Artree021/OpenTendonHand/pcb/README.md

# 电路板 / PCB

| 文件 | 说明 |
| --- | --- |
| `AD7606b-gerber.zip` | Gerber 打板文件（GTL/GBL/丝印/阻焊/板框等 19 个文件） |

完整的原理图、PCB、BOM 见**立创开源广场（OSHWHub）**，可在那里直接下单：

## https://oshwhub.com/shusheng60602/ad7606b

---

| File | Contents |
| --- | --- |
| `AD7606b-gerber.zip` | Gerber fabrication files |

Schematic, PCB and BOM are published on OSHWHub:

<https://oshwhub.com/shusheng60602/ad7606b>
