Artree021/OpenTendonHand/solidworks/磁编码器.SLDASM

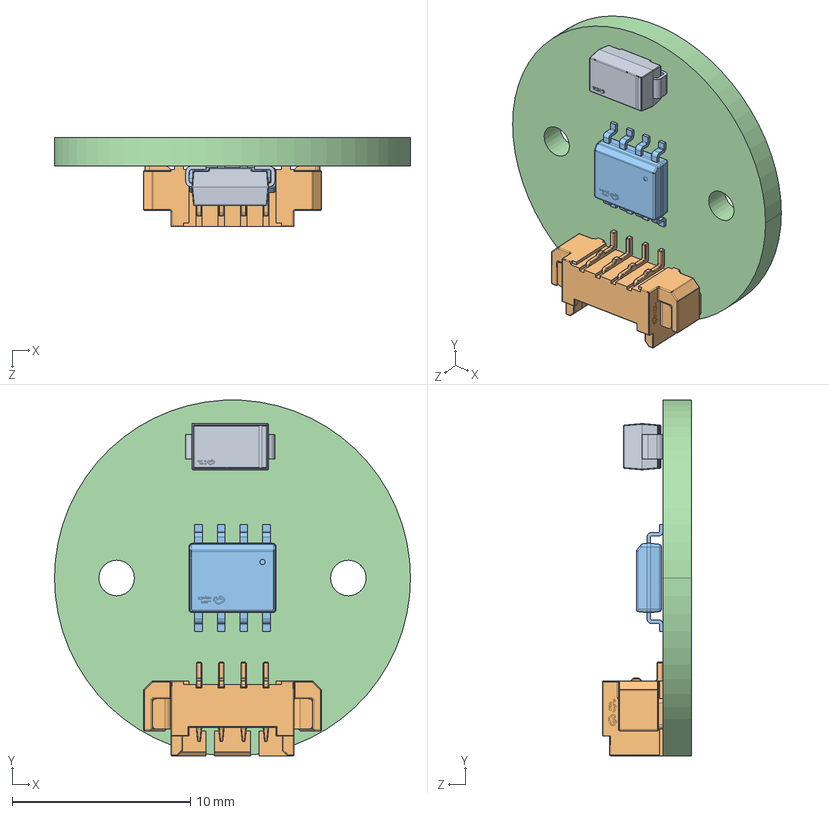
[picture p23: CAD file, 2026-11-03]
solidworks/磁编码器.SLDASM
20.0 x 19.9 x 5.00 mm
SOLID^SMA_L4.3-W2.6-LS5.0-RD_D18_磁编码器
COMPOUND^CONN-SMD_4P-P1.25-HC-1.25-4PWT_CN1_磁编码器
COMPOUND-1^SOP-8_L4.9-W3.9-P1.27-LS6.0-BL_U3_磁编码器
COMPOUND-3^磁编码器
