Artree021/OpenTendonHand/solidworks/驱动底座2.SLDASM

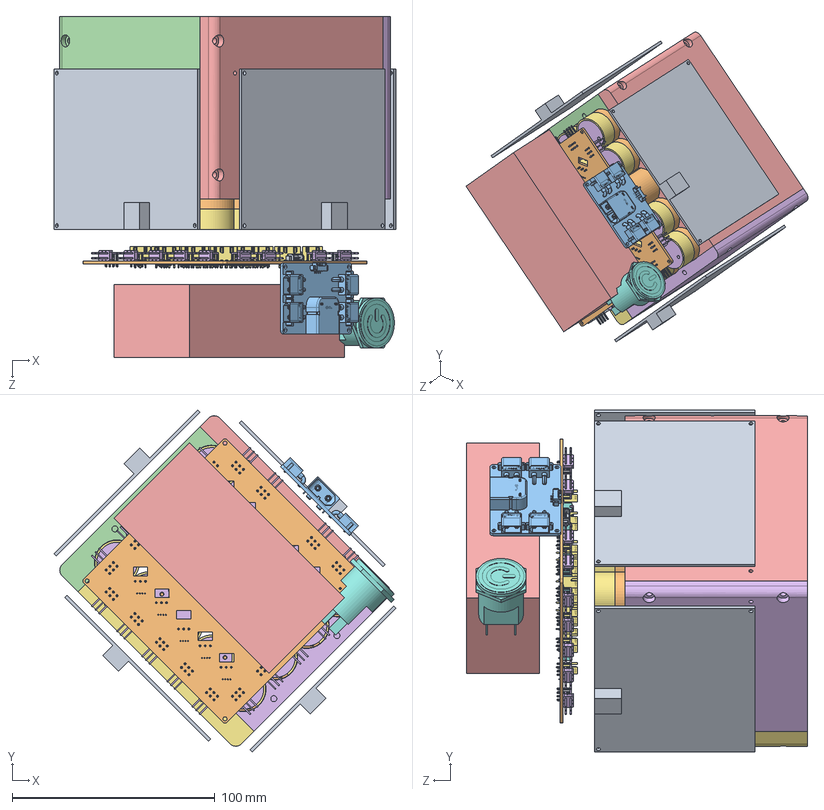
[picture p24: CAD file, 2026-11-03]
solidworks/驱动底座2.SLDASM
168.4 x 168.4 x 168.0 mm
空心杯电机 x 19
SOLID^SMA_L4.3-W2.6-LS5.0-RD_D18_磁编码器 x 19
COMPOUND^CONN-SMD_4P-P1.25-HC-1.25-4PWT_CN1_磁编码器 x 19
COMPOUND-1^SOP-8_L4.9-W3.9-P1.27-LS6.0-BL_U3_磁编码器 x 19
COMPOUND-3^磁编码器 x 19
配件1 x 19
电机轴套_双通 x 8
电机盖_双通 x 8
电机轴套_双通_test x 8
电机盖_单通_0714 x 11
电机轴套_单通_test x 11
6s电池
机械手控制电路板 x 4
HDR-TH_6P-P2.54-H-M-R2-C3-S2.54~HDR-TH_6P-P2.54-M-WI-2X3P~Z7h2^复件 H1~HDR-TH_6P-P2.54-H-M-R2-C3-S2.54~HDR-TH_6P-P2.54-M-WI-2X3P~Z7h2_电机底板 x 19
CONN-TH_3P-P2.54_2501S-3P~CONN-TH_3P-P2.54_2501S-3P~Z7h2^复件 CN1~CONN-TH_3P-P2.54_2501S-3P~CONN-TH_3P-P2.54_2501S-3P~Z7h2_电机底板 x 19
CONN-TH_DF13-4P-1.25DSA~CONN-TH_DF13-4P-1.25DSA~Z7h2^复件 CN2~CONN-TH_DF13-4P-1.25DSA~CONN-TH_DF13-4P-1.25DSA~Z7h2_电机底板 x 19
CONN-SMD_4P-P1.25-HC-1.25-4PWT~CONN-SMD_4P-P1.25-HC-1.25-4PWT~Z7h2^复件 CN39~CONN-SMD_4P-P1.25-HC-1.25-4PWT~CONN-SMD_4P-P1.25-HC-1.25-4PWT~Z7h2_电机底板
复件 Board~Z7h2
总电源板
底座侧罩1
底座侧罩2
底座侧罩3
底座侧罩4
电源按键
