Artree021/OpenTendonHand/solidworks/双通关节模组.SLDASM

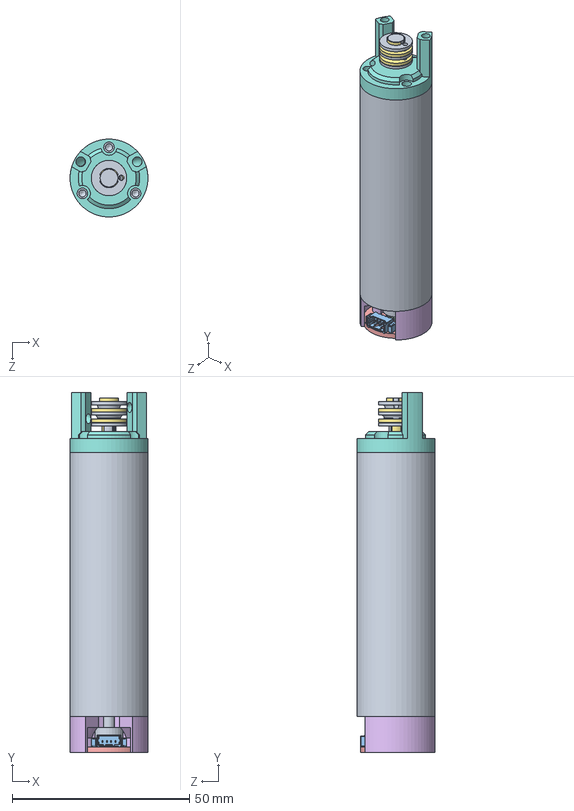
[picture p25: CAD file, 2026-11-03]
solidworks/双通关节模组.SLDASM
22.0 x 101.6 x 22.0 mm
空心杯电机
SOLID^SMA_L4.3-W2.6-LS5.0-RD_D18_磁编码器
COMPOUND^CONN-SMD_4P-P1.25-HC-1.25-4PWT_CN1_磁编码器
COMPOUND-1^SOP-8_L4.9-W3.9-P1.27-LS6.0-BL_U3_磁编码器
COMPOUND-3^磁编码器
配件1
电机盖_双通
电机轴套_双通_test
