Artree021/OpenTendonHand/solidworks/二代全手搭建_圆盘型_all.SLDASM

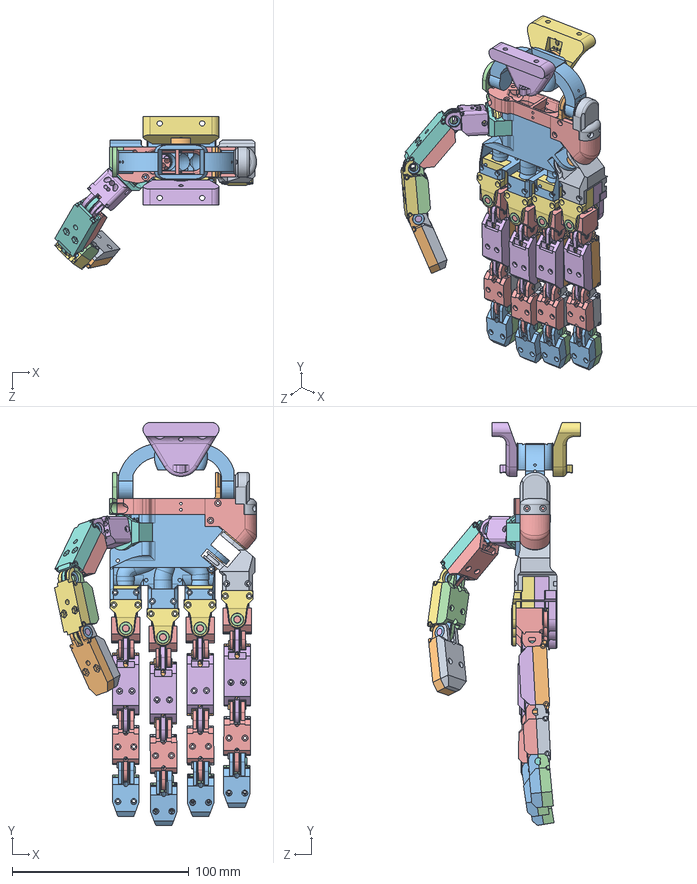
[picture p27: CAD file, 2026-11-03]
solidworks/二代全手搭建_圆盘型_all.SLDASM
114.2 x 227.7 x 86.6 mm
小法兰轴承_代2圆盘型_all x 16
前远指节_代2圆盘型_all x 4
前近指节_代2圆盘型_all x 4
前底座_代2圆盘型_all x 4
关节轴_代2圆盘型_all x 4
后远指节_代2圆盘型_all x 4
后近指节_代2圆盘型_all x 4
前指拇_代2圆盘型_all x 4
后指拇_代2圆盘型_all x 4
左根部座_2版_代2圆盘型_all x 4
后底座_代2圆盘型_all x 4
P_关节电位器_代2圆盘型_all x 19
P2_关节电位器_代2圆盘型_all x 19
手掌固定架_代2圆盘型_all
小拇指固定架1_代2圆盘型_all
8_14_4法兰轴承_代2圆盘型_all x 3
小指拇固定架2_代2圆盘型_all
小法兰轴承_圆盘型_all x 2
前远指节_圆盘型_all
前近指节_圆盘型_all
关节轴_圆盘型_all
后远指节_圆盘型_all
后近指节_圆盘型_all
前指拇_圆盘型_all
后指拇_圆盘型_all
P_关节电位器_圆盘型_all x 4
P2_关节电位器_圆盘型_all x 4
8_14_4法兰轴承_all x 2
左根部座_圆盘型2_all
大拇指根部件1_all
大拇指根部件2_all
8_12_3.5法兰轴承_all x 3
手掌固定架3_代2圆盘型_all
手掌固定架4_代2圆盘型_all
腕部支撑架1
手掌固定架5_代2圆盘型_all
手掌固定架2_代2圆盘型_all
腕部支撑架2
腕部支撑架3
