Artree021/OpenTendonHand/solidworks/关节电位器_代2圆盘型_all.SLDASM

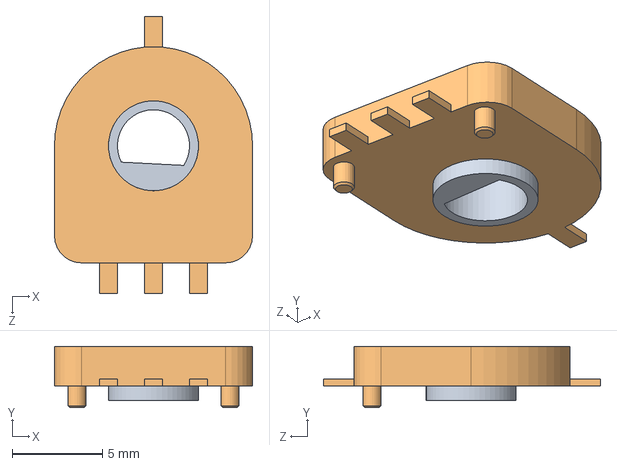
[picture p28: CAD file, 2026-11-03]
solidworks/关节电位器_代2圆盘型_all.SLDASM
11.0 x 3.40 x 15.4 mm
P_关节电位器_代2圆盘型_all
P2_关节电位器_代2圆盘型_all
