Artree021/OpenTendonHand/step/机械手整体.STEP

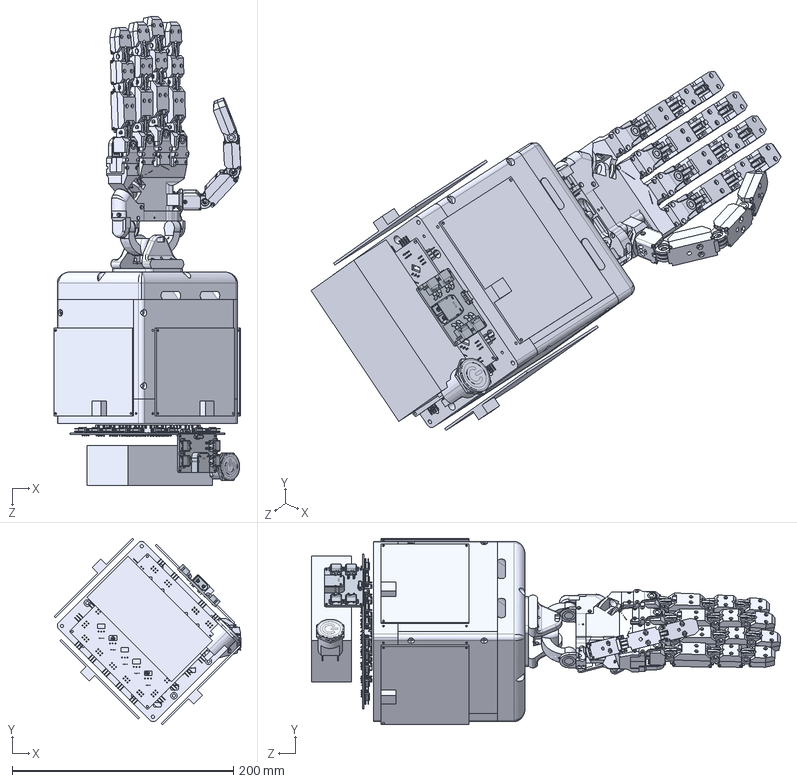
[picture p29: CAD file, 2026-11-03]
step/机械手整体.STEP
168.7 x 168.4 x 423.7 mm
小法兰轴承_代2圆盘型_all x 16
前远指节_代2圆盘型_all x 4
前近指节_代2圆盘型_all x 4
前底座_代2圆盘型_all x 4
关节轴_代2圆盘型_all x 4
后远指节_代2圆盘型_all x 4
后近指节_代2圆盘型_all x 4
前指拇_代2圆盘型_all x 4
后指拇_代2圆盘型_all x 4
左根部座_2版_代2圆盘型_all x 4
后底座_代2圆盘型_all x 4
P_关节电位器_代2圆盘型_all x 19
P2_关节电位器_代2圆盘型_all x 19
手掌固定架_代2圆盘型_all
小拇指固定架1_代2圆盘型_all
8_14_4法兰轴承_代2圆盘型_all x 3
小指拇固定架2_代2圆盘型_all
小法兰轴承_圆盘型_all x 2
前远指节_圆盘型_all
前近指节_圆盘型_all
关节轴_圆盘型_all
后远指节_圆盘型_all
后近指节_圆盘型_all
前指拇_圆盘型_all
后指拇_圆盘型_all
P_关节电位器_圆盘型_all x 4
P2_关节电位器_圆盘型_all x 4
8_14_4法兰轴承_all x 2
左根部座_圆盘型2_all
大拇指根部件1_all
大拇指根部件2_all
8_12_3.5法兰轴承_all x 3
手掌固定架3_代2圆盘型_all
手掌固定架4_代2圆盘型_all
腕部支撑架1
手掌固定架5_代2圆盘型_all
手掌固定架2_代2圆盘型_all
腕部支撑架2
腕部支撑架3
空心杯电机 x 19
SOLID^SMA_L4.3-W2.6-LS5.0-RD_D18_磁编码器 x 19
COMPOUND^CONN-SMD_4P-P1.25-HC-1.25-4PWT_CN1_磁编码器 x 19
COMPOUND-1^SOP-8_L4.9-W3.9-P1.27-LS6.0-BL_U3_磁编码器 x 19
COMPOUND-3^磁编码器 x 19
配件1 x 19
电机轴套_双通 x 8
电机盖_双通 x 8
电机轴套_双通_test x 8
电机总底座2
电机盖_单通_0714 x 11
电机轴套_单通_test x 11
6s电池
机械手控制电路板 x 4
HDR-TH_6P-P2.54-H-M-R2-C3-S2.54~HDR-TH_6P-P2.54-M-WI-2X3P~Z7h2^复件 H1~HDR-TH_6P-P2.54-H-M-R2-C3-S2.54~HDR-TH_6P-P2.54-M-WI-2X3P~Z7h2_电机底板 x 19
CONN-TH_3P-P2.54_2501S-3P~CONN-TH_3P-P2.54_2501S-3P~Z7h2^复件 CN1~CONN-TH_3P-P2.54_2501S-3P~CONN-TH_3P-P2.54_2501S-3P~Z7h2_电机底板 x 19
CONN-TH_DF13-4P-1.25DSA~CONN-TH_DF13-4P-1.25DSA~Z7h2^复件 CN2~CONN-TH_DF13-4P-1.25DSA~CONN-TH_DF13-4P-1.25DSA~Z7h2_电机底板 x 19
CONN-SMD_4P-P1.25-HC-1.25-4PWT~CONN-SMD_4P-P1.25-HC-1.25-4PWT~Z7h2^复件 CN39~CONN-SMD_4P-P1.25-HC-1.25-4PWT~CONN-SMD_4P-P1.25-HC-1.25-4PWT~Z7h2_电机底板
复件 Board~Z7h2
总电源板
底座侧罩1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
