Artree021/OpenTendonHand/solidworks/前远指节_圆盘型_all.SLDPRT

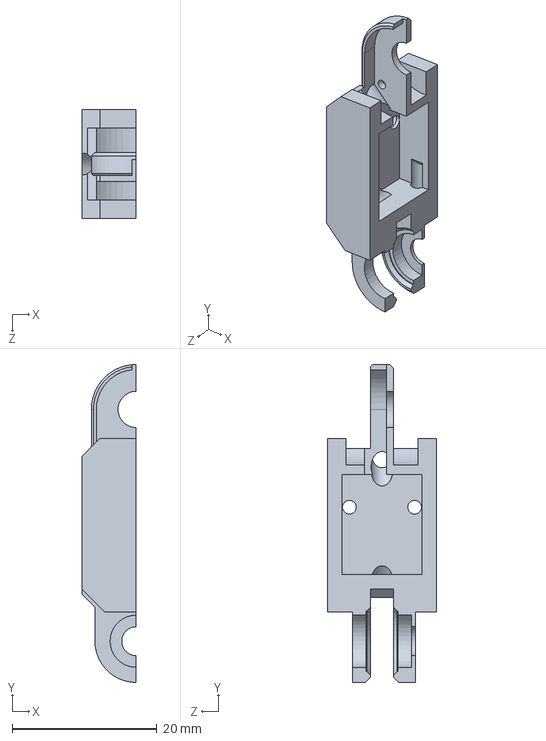
[picture p30: CAD file, 2026-11-03]
solidworks/前远指节_圆盘型_all.SLDPRT
7.50 x 43.9 x 15.0 mm
