Artree021/OpenTendonHand/solidworks/小法兰轴承_圆盘型_all.SLDPRT

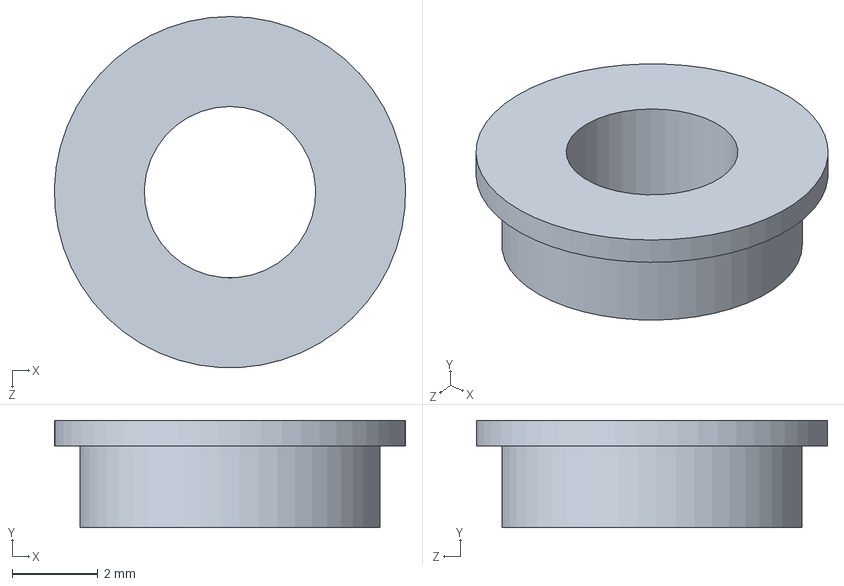
[picture p31: CAD file, 2026-11-03]
solidworks/小法兰轴承_圆盘型_all.SLDPRT
8.20 x 2.50 x 8.19 mm
