Artree021/OpenTendonHand/solidworks/前指拇_代2圆盘型_all.SLDPRT

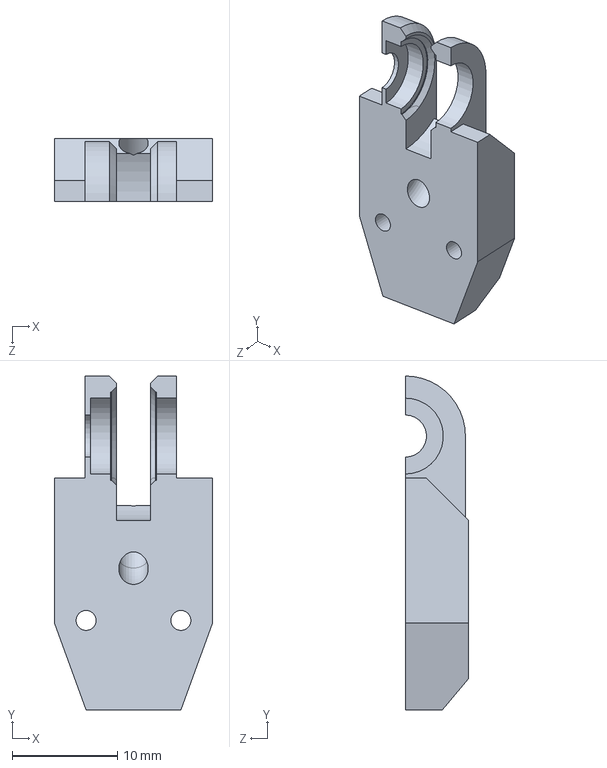
[picture p33: CAD file, 2026-11-03]
solidworks/前指拇_代2圆盘型_all.SLDPRT
15.0 x 31.7 x 6.00 mm
