Artree021/OpenTendonHand/solidworks/底座侧罩1.SLDPRT

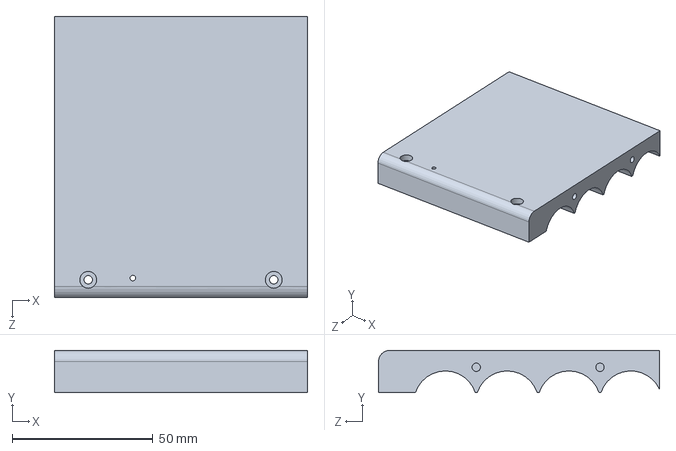
[picture p34: CAD file, 2026-11-03]
solidworks/底座侧罩1.SLDPRT
90.0 x 15.0 x 100.0 mm
