Artree021/OpenTendonHand/solidworks/全手底端.SLDPRT

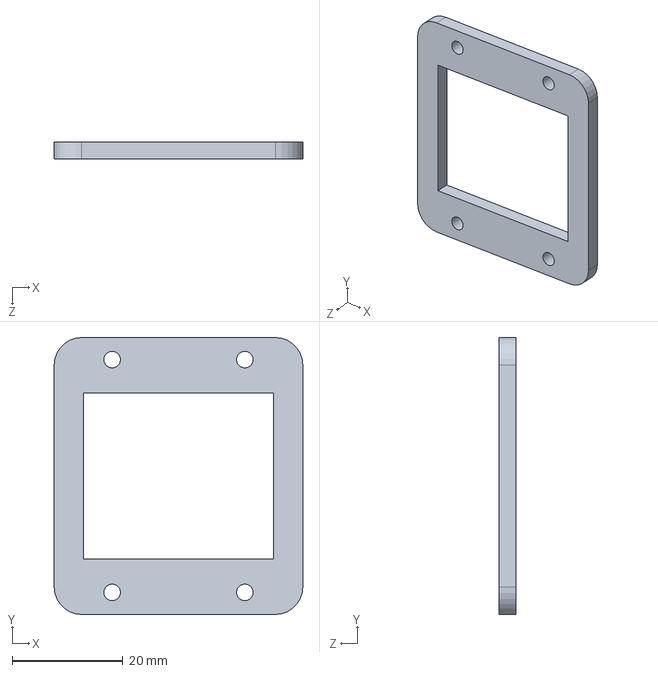
[picture p35: CAD file, 2026-11-03]
solidworks/全手底端.SLDPRT
45.0 x 50.1 x 3.00 mm
