Artree021/OpenTendonHand/solidworks/电机盖_双通.SLDPRT

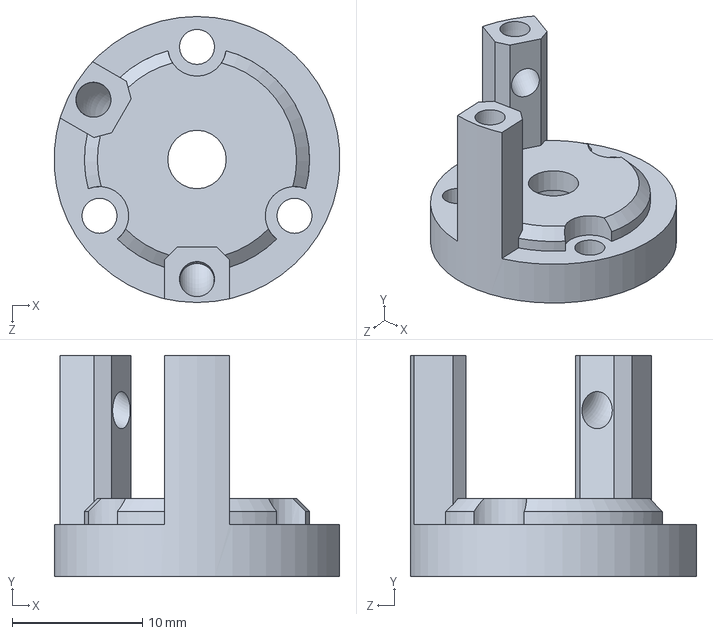
[picture p36: CAD file, 2026-11-03]
solidworks/电机盖_双通.SLDPRT
22.0 x 17.0 x 22.0 mm
