Artree021/OpenTendonHand/solidworks/8_12_3.5法兰轴承_all.SLDPRT

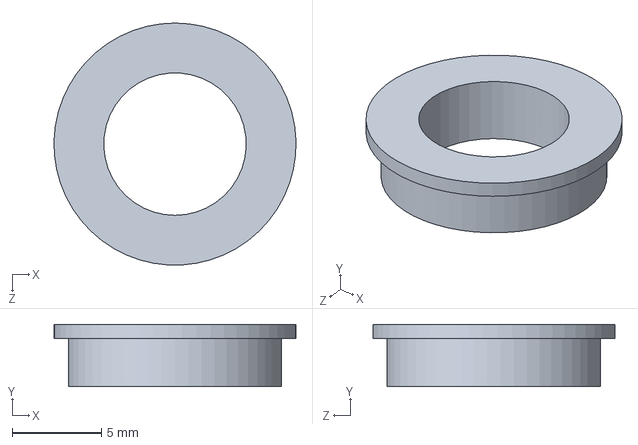
[picture p37: CAD file, 2026-11-03]
solidworks/8_12_3.5法兰轴承_all.SLDPRT
13.6 x 3.50 x 13.6 mm
