Artree021/OpenTendonHand/solidworks/8_14_4法兰轴承_all.SLDPRT

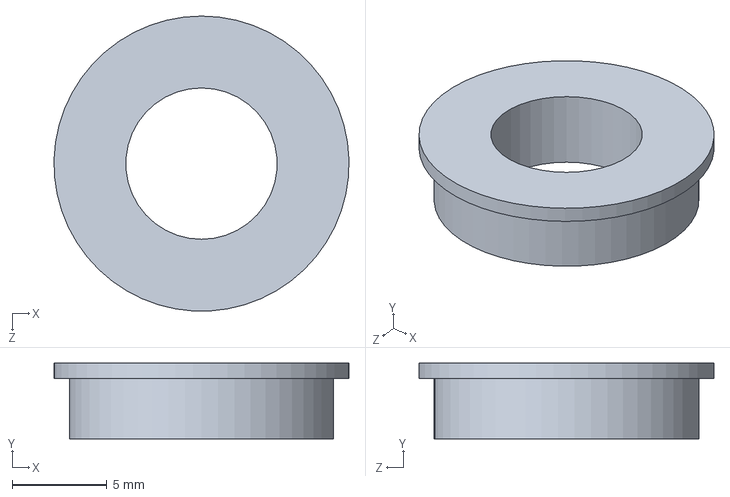
[picture p38: CAD file, 2026-11-03]
solidworks/8_14_4法兰轴承_all.SLDPRT
15.6 x 4.00 x 15.6 mm
