Artree021/OpenTendonHand/solidworks/小拇指固定架1_代2圆盘型_all.SLDPRT

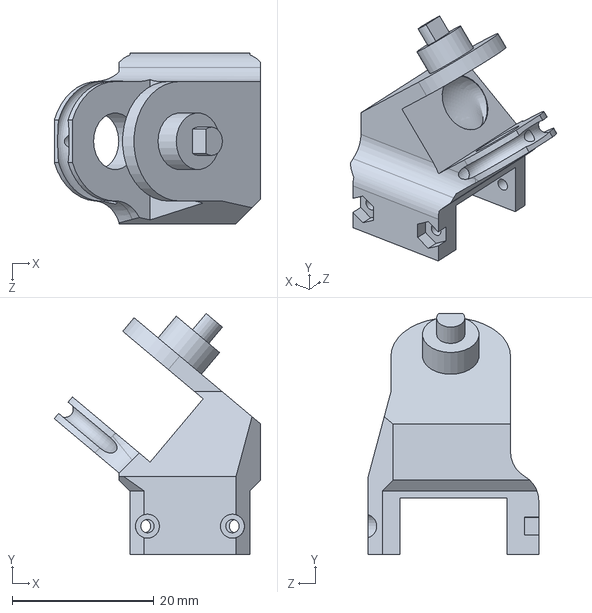
[picture p39: CAD file, 2026-11-03]
solidworks/小拇指固定架1_代2圆盘型_all.SLDPRT
29.2 x 34.0 x 24.1 mm
