Artree021/OpenTendonHand/solidworks/前近指节_圆盘型_all.SLDPRT

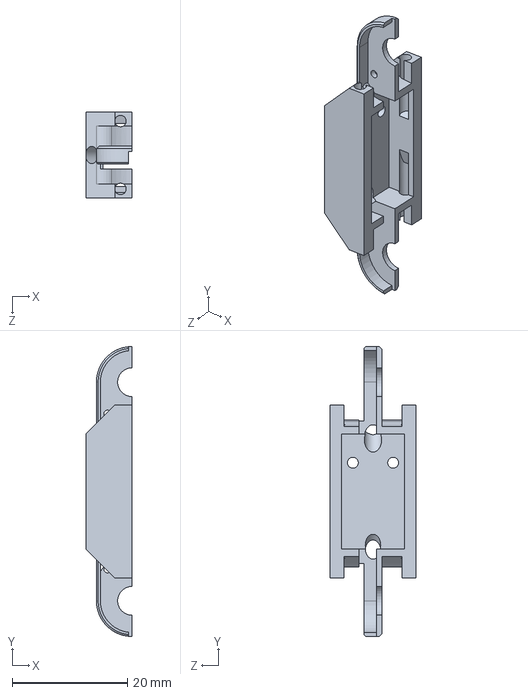
[picture p40: CAD file, 2026-11-03]
solidworks/前近指节_圆盘型_all.SLDPRT
8.00 x 50.4 x 15.0 mm
