Artree021/OpenTendonHand/solidworks/底座侧罩3.SLDPRT

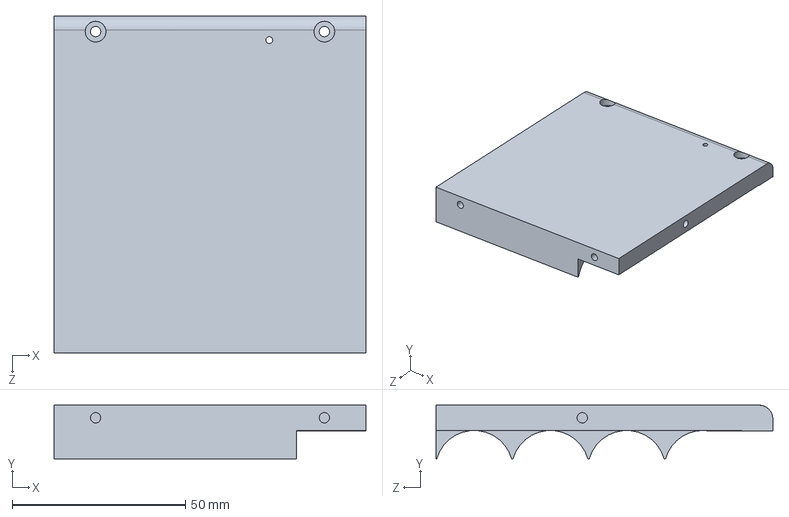
[picture p41: CAD file, 2026-11-03]
solidworks/底座侧罩3.SLDPRT
90.0 x 15.5 x 97.2 mm
