Artree021/OpenTendonHand/solidworks/电机轴套_单通_test.SLDPRT

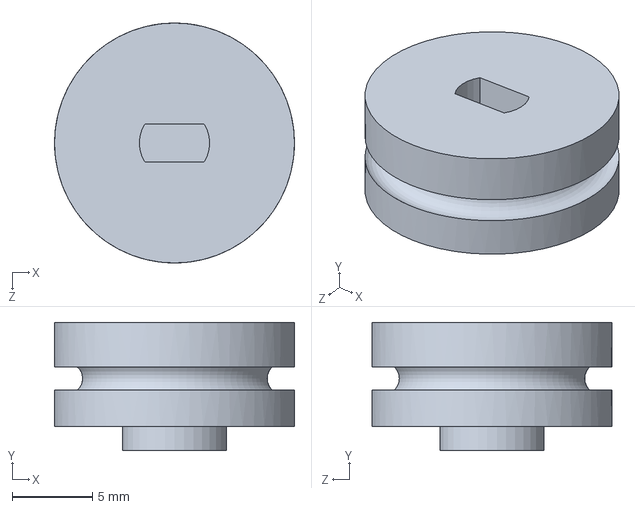
[picture p42: CAD file, 2026-11-03]
solidworks/电机轴套_单通_test.SLDPRT
15.0 x 8.00 x 15.0 mm
