Artree021/OpenTendonHand/solidworks/机械手控制电路板.SLDPRT

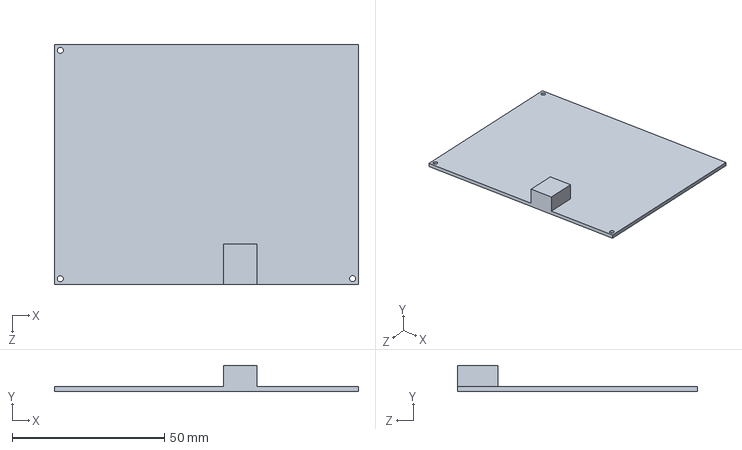
[picture p43: CAD file, 2026-11-03]
solidworks/机械手控制电路板.SLDPRT
100.0 x 8.60 x 79.1 mm
