Artree021/OpenTendonHand/solidworks/电机轴套_双通_test.SLDPRT

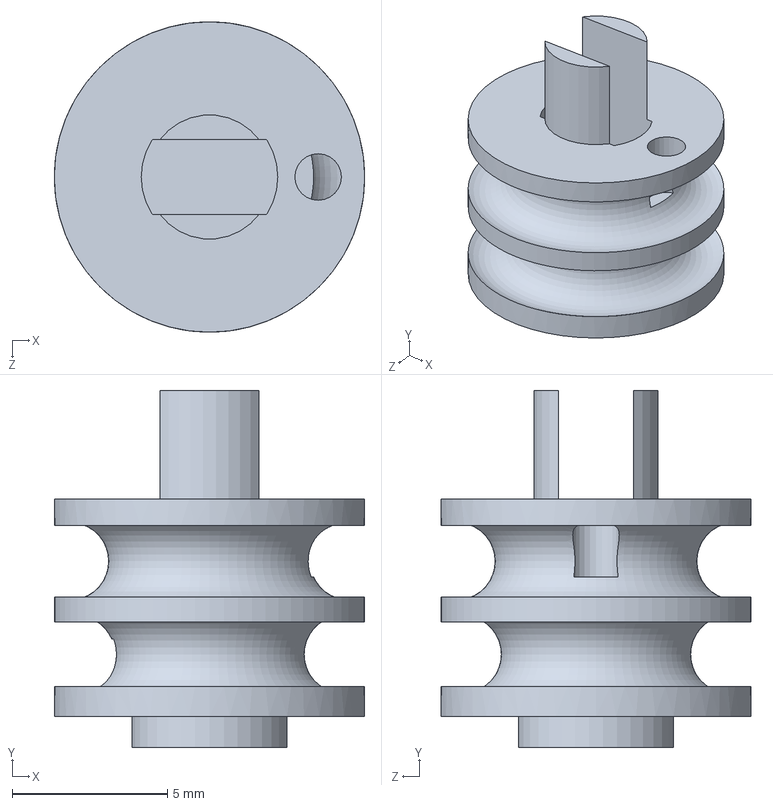
[picture p44: CAD file, 2026-11-03]
solidworks/电机轴套_双通_test.SLDPRT
10.0 x 11.5 x 10.0 mm
