Artree021/OpenTendonHand/solidworks/后远指节_圆盘型_all.SLDPRT

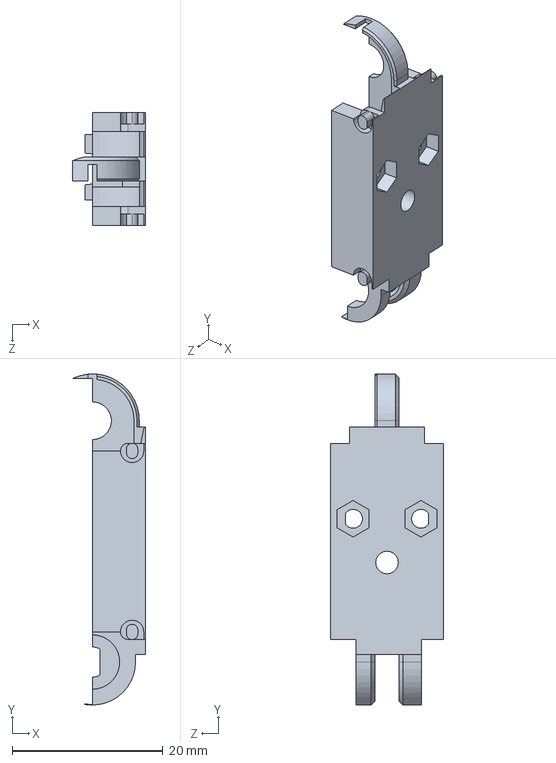
[picture p45: CAD file, 2026-11-03]
solidworks/后远指节_圆盘型_all.SLDPRT
9.64 x 43.9 x 15.0 mm
