Artree021/OpenTendonHand/solidworks/手掌固定架_代2圆盘型_all.SLDPRT

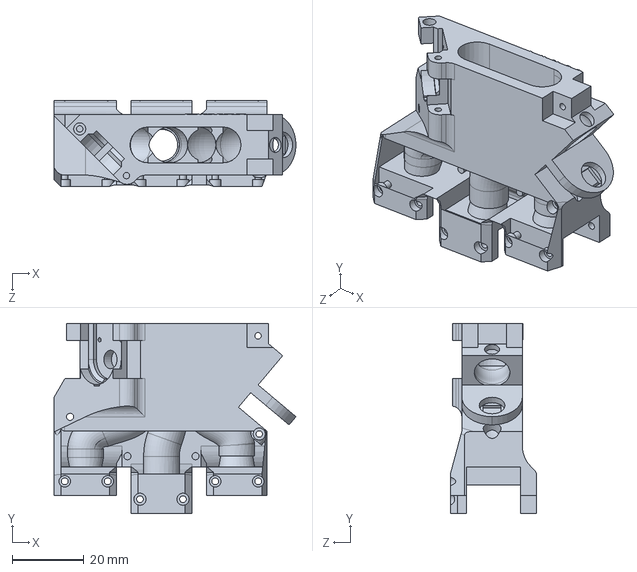
[picture p46: CAD file, 2026-11-03]
solidworks/手掌固定架_代2圆盘型_all.SLDPRT
67.5 x 53.1 x 24.1 mm
