Artree021/OpenTendonHand/solidworks/腕部支撑架3.SLDPRT

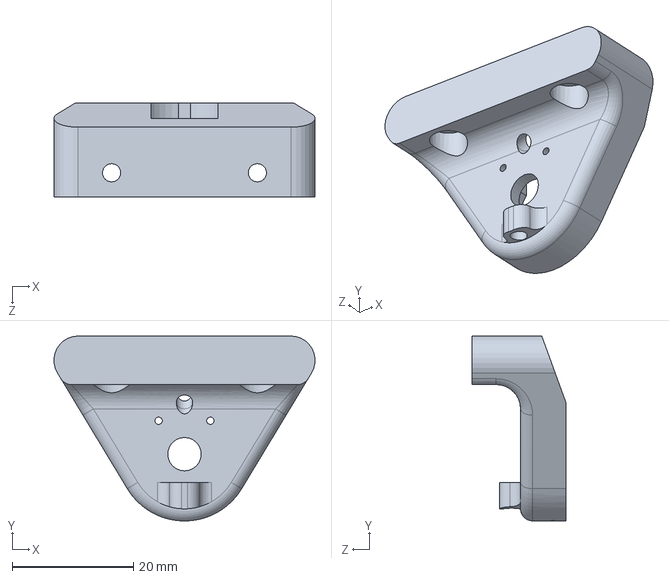
[picture p47: CAD file, 2026-11-03]
solidworks/腕部支撑架3.SLDPRT
43.0 x 30.4 x 15.5 mm
