Artree021/OpenTendonHand/solidworks/左根部座_圆盘型2_all.SLDPRT

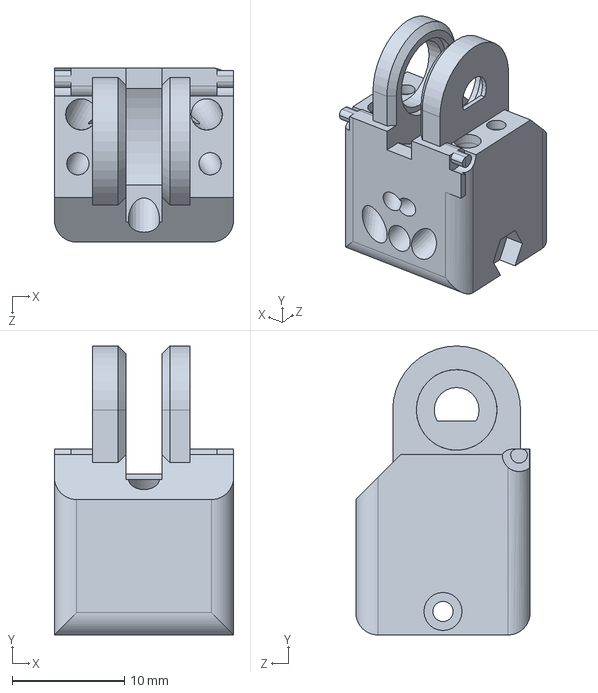
[picture p48: CAD file, 2026-11-03]
solidworks/左根部座_圆盘型2_all.SLDPRT
16.0 x 25.8 x 15.6 mm
