Artree021/OpenTendonHand/solidworks/小指拇固定架2_代2圆盘型_all.SLDPRT

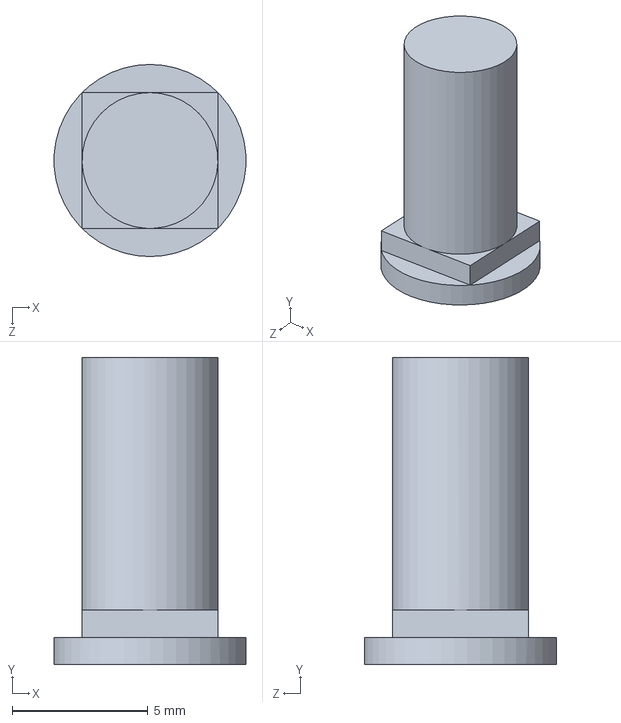
[picture p49: CAD file, 2026-11-03]
solidworks/小指拇固定架2_代2圆盘型_all.SLDPRT
7.05 x 11.3 x 7.07 mm
