Artree021/OpenTendonHand/solidworks/前底座_代2圆盘型_all.SLDPRT

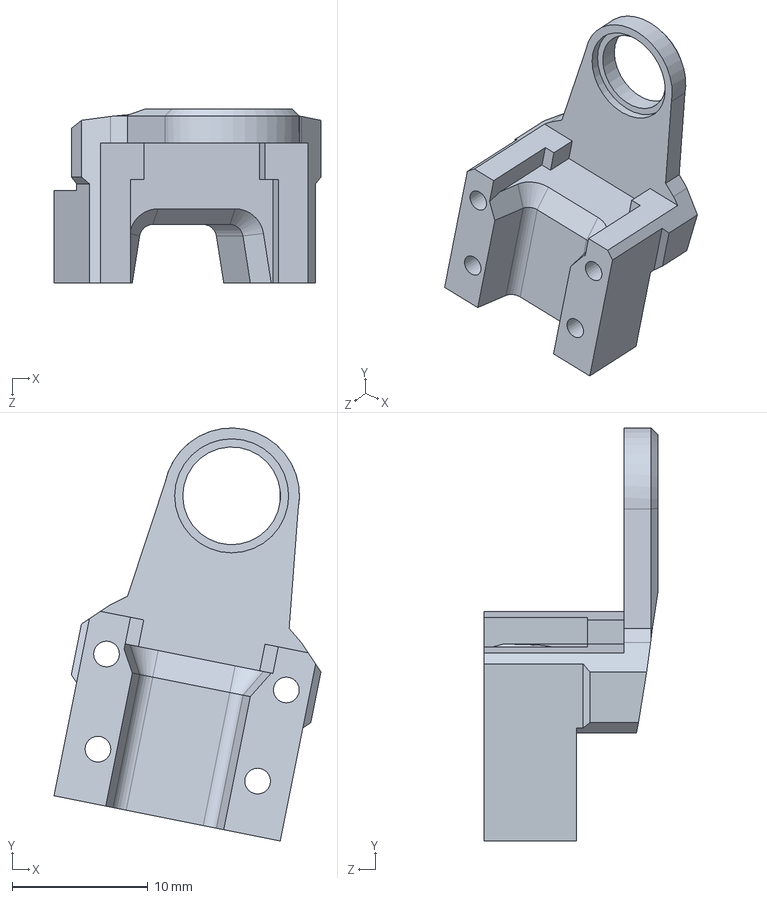
[picture p50: CAD file, 2026-11-03]
solidworks/前底座_代2圆盘型_all.SLDPRT
19.7 x 30.4 x 12.8 mm
