Artree021/OpenTendonHand/solidworks/6s电池.SLDPRT

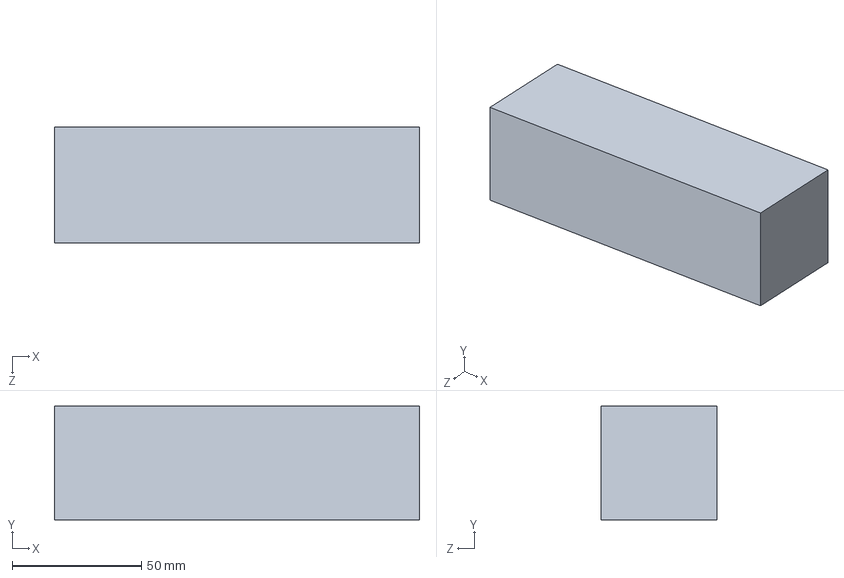
[picture p51: CAD file, 2026-11-03]
solidworks/6s电池.SLDPRT
141.0 x 44.0 x 45.0 mm
