Artree021/OpenTendonHand/solidworks/手掌固定架4_代2圆盘型_all.SLDPRT

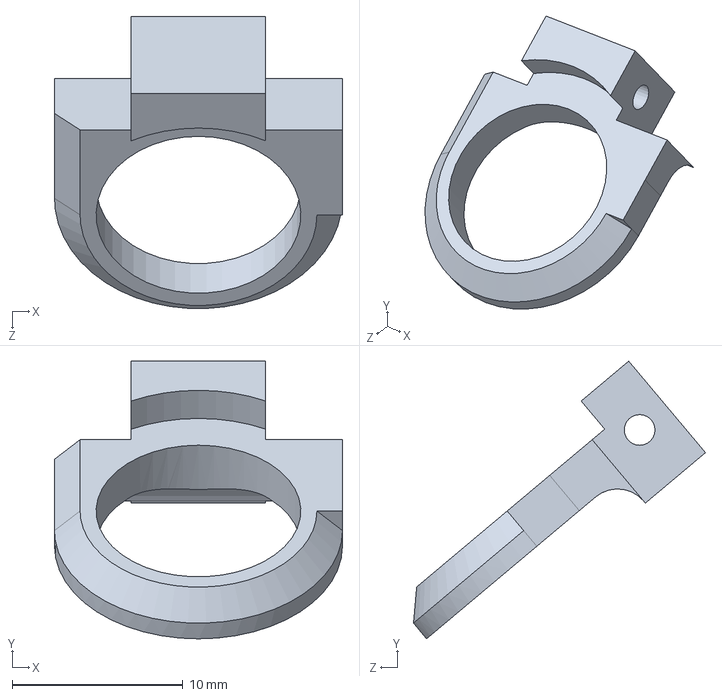
[picture p52: CAD file, 2026-11-03]
solidworks/手掌固定架4_代2圆盘型_all.SLDPRT
16.9 x 16.3 x 17.1 mm
