Artree021/OpenTendonHand/solidworks/logo外壳.SLDPRT

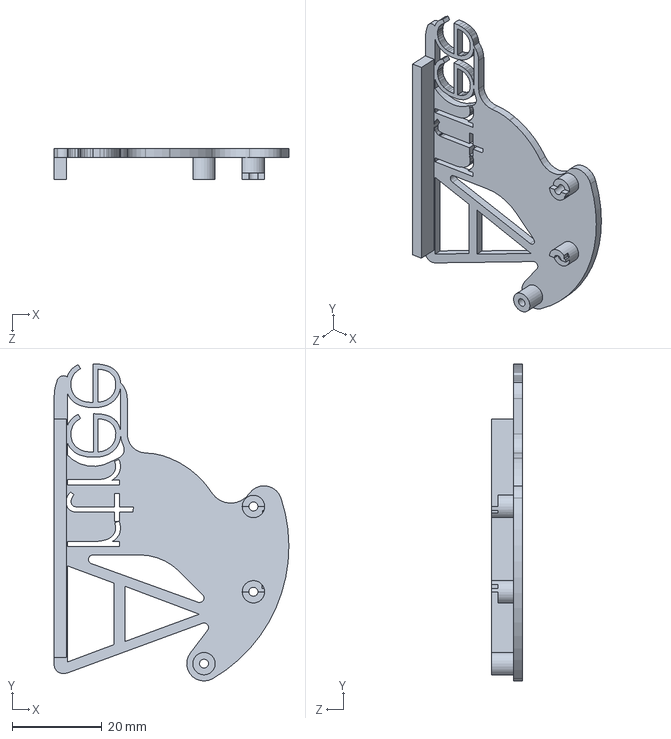
[picture p53: CAD file, 2026-11-03]
solidworks/logo外壳.SLDPRT
52.3 x 70.6 x 7.00 mm
