Artree021/OpenTendonHand/solidworks/后远指节_代2圆盘型_all.SLDPRT

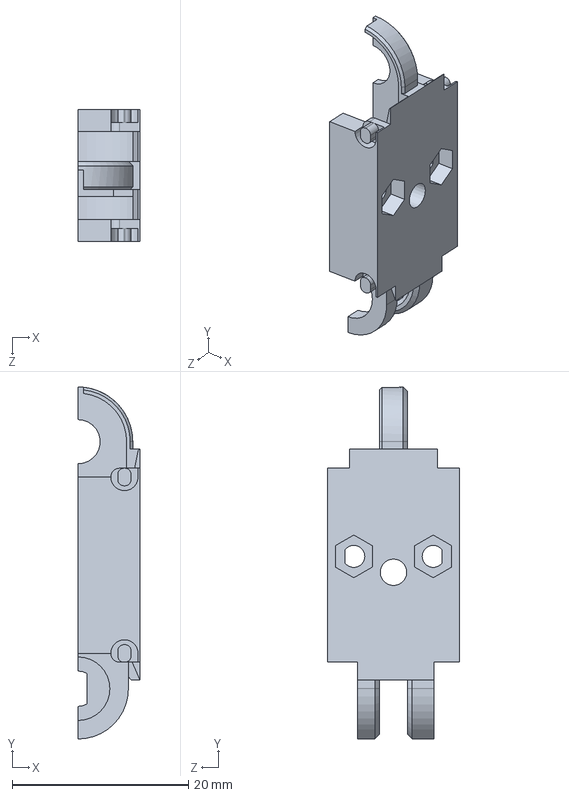
[picture p54: CAD file, 2026-11-03]
solidworks/后远指节_代2圆盘型_all.SLDPRT
7.00 x 39.9 x 15.0 mm
