Artree021/OpenTendonHand/solidworks/P_关节电位器_代2圆盘型_all.SLDPRT

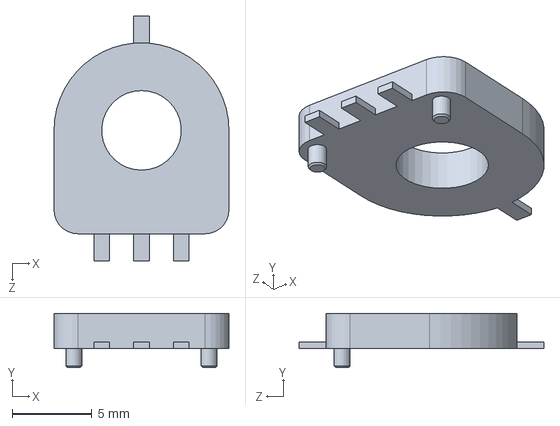
[picture p55: CAD file, 2026-11-03]
solidworks/P_关节电位器_代2圆盘型_all.SLDPRT
11.0 x 3.40 x 15.4 mm
