Artree021/OpenTendonHand/solidworks/底座顶2.SLDPRT

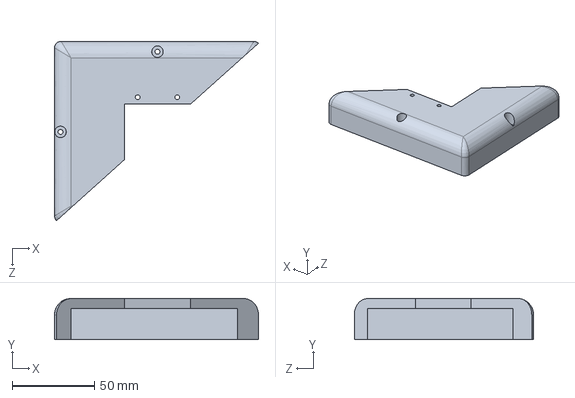
[picture p56: CAD file, 2026-11-03]
solidworks/底座顶2.SLDPRT
123.8 x 25.0 x 108.9 mm
