Artree021/OpenTendonHand/solidworks/后底座_代2圆盘型_all.SLDPRT

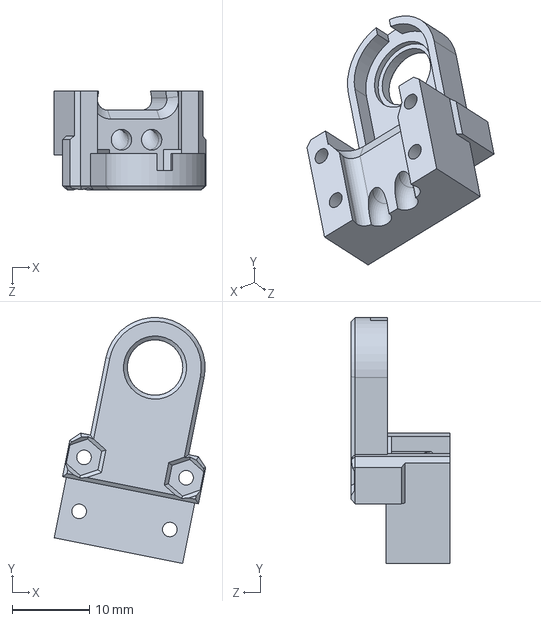
[picture p57: CAD file, 2026-11-03]
solidworks/后底座_代2圆盘型_all.SLDPRT
19.7 x 31.9 x 12.8 mm
