Artree021/OpenTendonHand/solidworks/配件1.SLDPRT

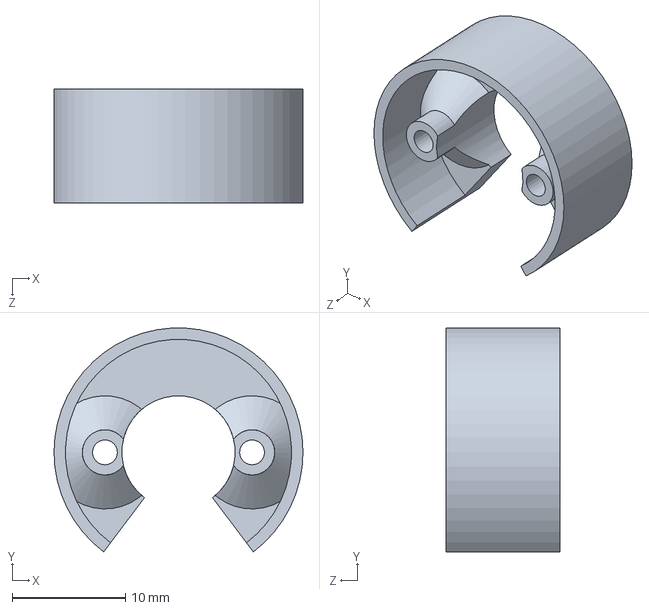
[picture p58: CAD file, 2026-11-03]
solidworks/配件1.SLDPRT
22.0 x 19.8 x 10.1 mm
