Artree021/OpenTendonHand/solidworks/大拇指根部件1_all.SLDPRT

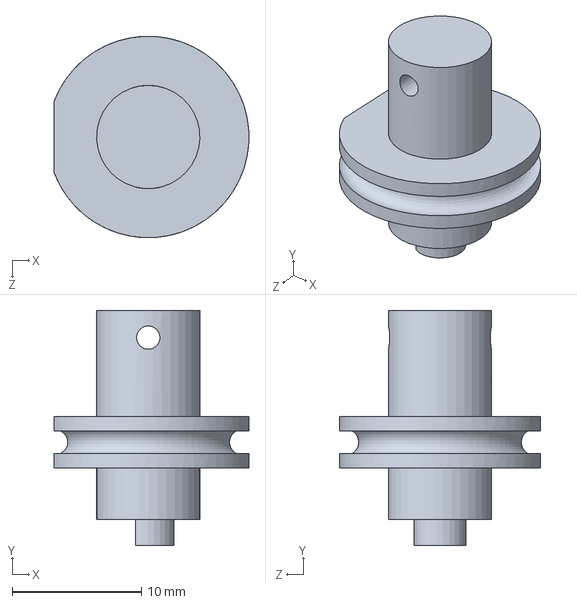
[picture p59: CAD file, 2026-11-03]
solidworks/大拇指根部件1_all.SLDPRT
15.1 x 18.2 x 15.6 mm
