Artree021/OpenTendonHand/solidworks/手掌固定架2_代2圆盘型_all.SLDPRT

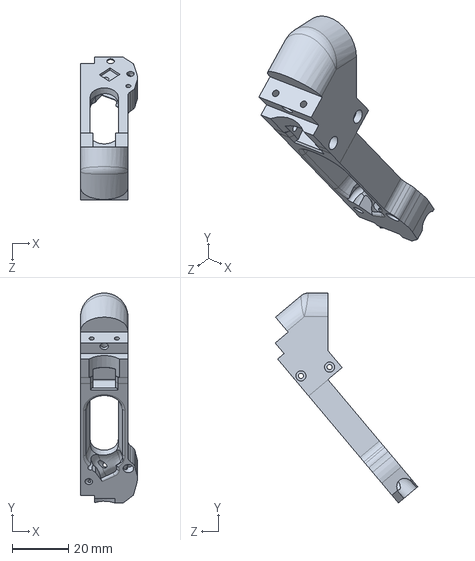
[picture p60: CAD file, 2026-11-03]
solidworks/手掌固定架2_代2圆盘型_all.SLDPRT
20.3 x 74.7 x 50.7 mm
