Artree021/OpenTendonHand/solidworks/左根部座_2版_代2圆盘型_all.SLDPRT

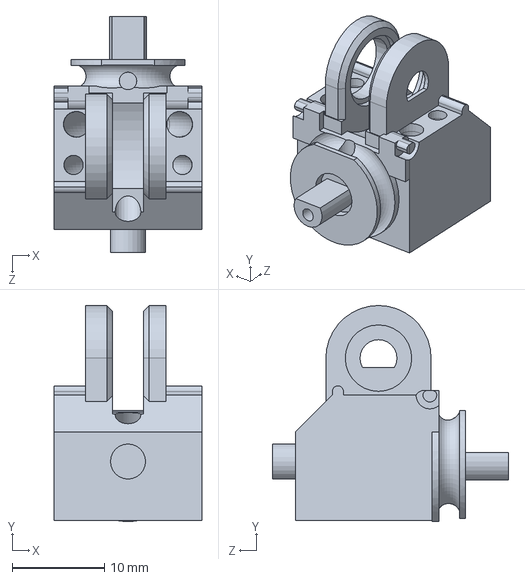
[picture p61: CAD file, 2026-11-03]
solidworks/左根部座_2版_代2圆盘型_all.SLDPRT
16.0 x 23.4 x 25.6 mm
