Artree021/OpenTendonHand/solidworks/手掌固定架3_代2圆盘型_all.SLDPRT

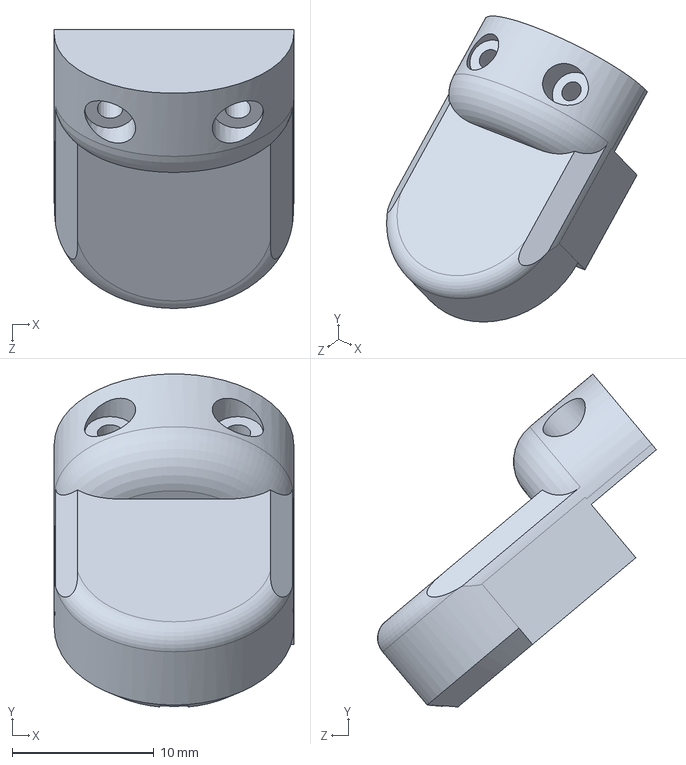
[picture p62: CAD file, 2026-11-03]
solidworks/手掌固定架3_代2圆盘型_all.SLDPRT
16.9 x 23.5 x 19.6 mm
