Artree021/OpenTendonHand/solidworks/电机盖_单通_0714.SLDPRT

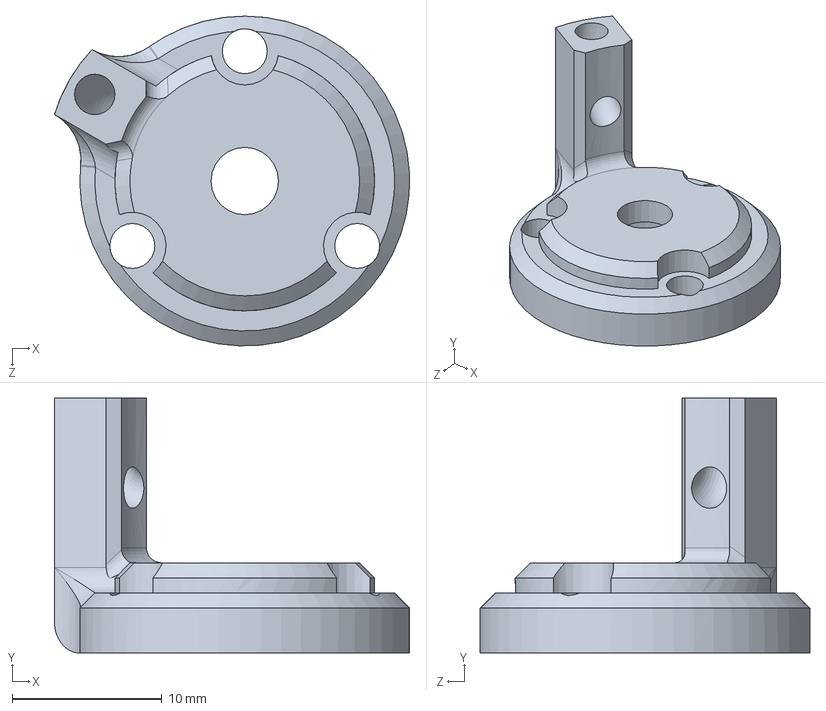
[picture p63: CAD file, 2026-11-03]
solidworks/电机盖_单通_0714.SLDPRT
23.7 x 17.0 x 22.0 mm
