Artree021/OpenTendonHand/solidworks/P2_关节电位器_代2圆盘型_all.SLDPRT

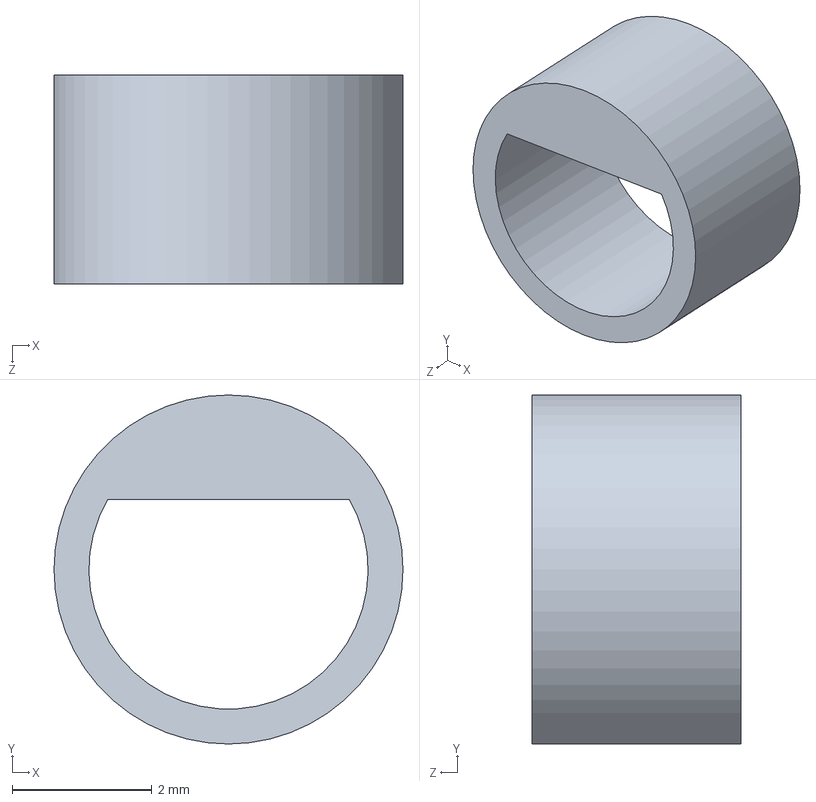
[picture p65: CAD file, 2026-11-03]
solidworks/P2_关节电位器_代2圆盘型_all.SLDPRT
5.00 x 5.00 x 3.00 mm
