Artree021/OpenTendonHand/solidworks/手掌固定架5_代2圆盘型_all.SLDPRT

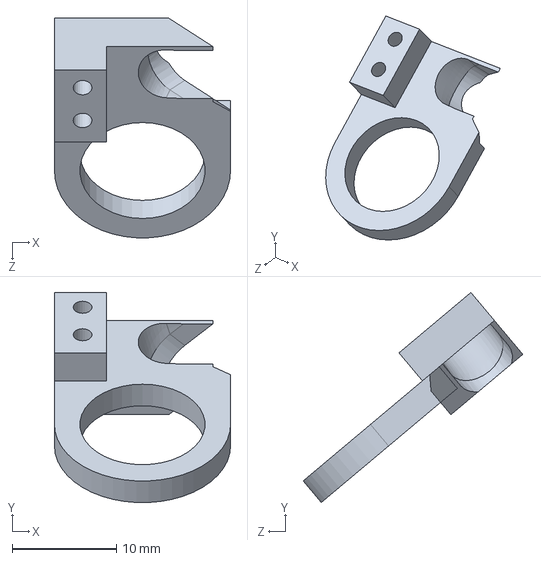
[picture p66: CAD file, 2026-11-03]
solidworks/手掌固定架5_代2圆盘型_all.SLDPRT
16.9 x 20.1 x 21.0 mm
