Artree021/OpenTendonHand/solidworks/电机总底座2.SLDPRT

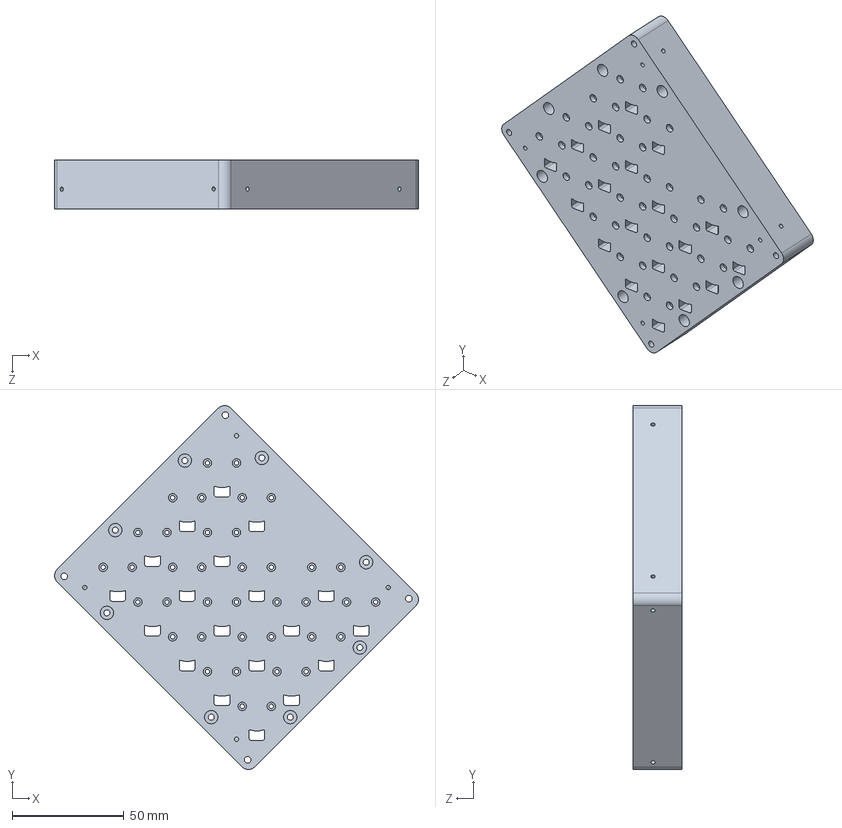
[picture p68: CAD file, 2026-11-03]
solidworks/电机总底座2.SLDPRT
162.8 x 162.8 x 22.0 mm
