Artree021/OpenTendonHand/solidworks/空心杯电机.SLDPRT

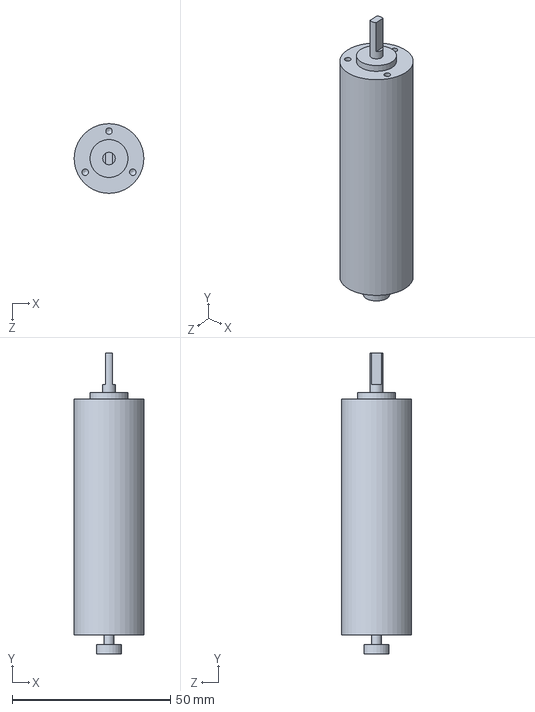
[picture p69: CAD file, 2026-11-03]
solidworks/空心杯电机.SLDPRT
22.0 x 95.0 x 22.0 mm
