Artree021/OpenTendonHand/solidworks/前远指节_代2圆盘型_all.SLDPRT

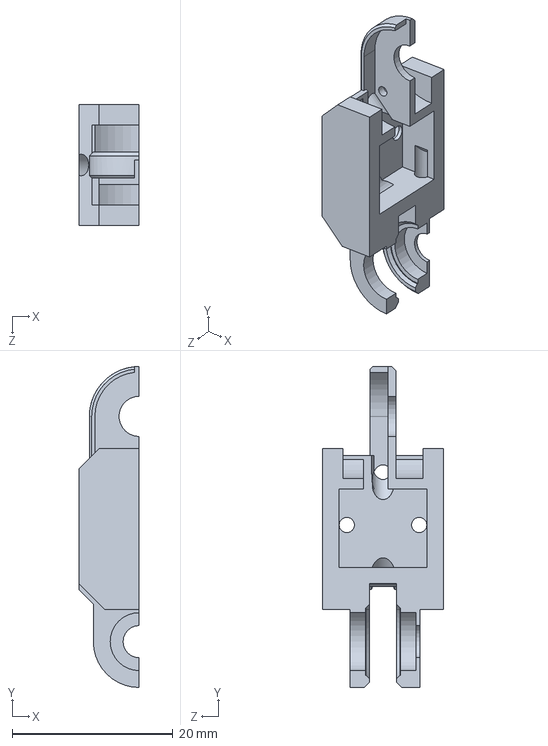
[picture p70: CAD file, 2026-11-03]
solidworks/前远指节_代2圆盘型_all.SLDPRT
7.50 x 39.9 x 15.0 mm
