Artree021/OpenTendonHand/solidworks/电源按键.SLDPRT

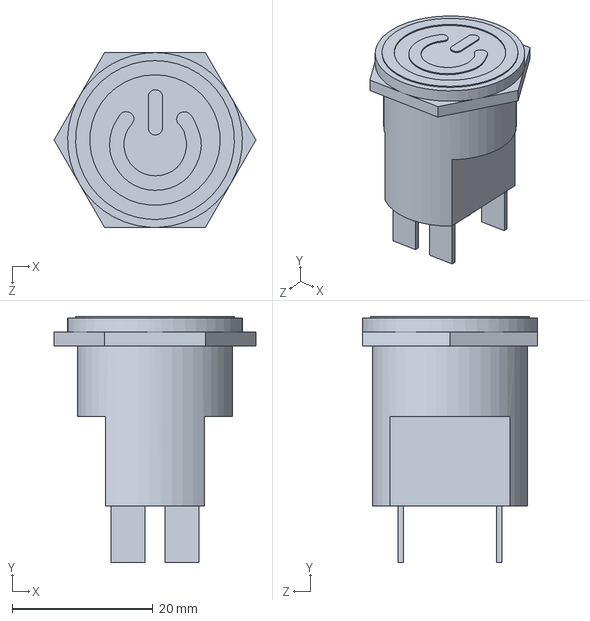
[picture p71: CAD file, 2026-11-03]
solidworks/电源按键.SLDPRT
28.6 x 34.9 x 24.8 mm
