Artree021/OpenTendonHand/solidworks/腕部支撑架2.SLDPRT

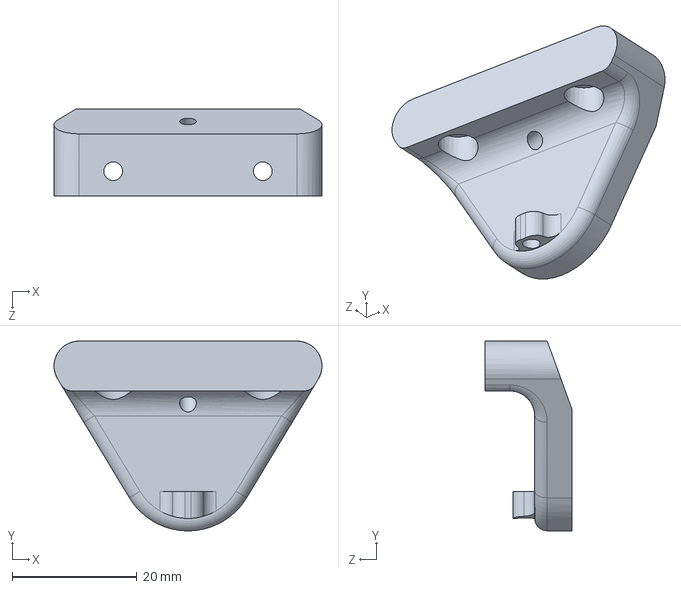
[picture p72: CAD file, 2026-11-03]
solidworks/腕部支撑架2.SLDPRT
43.0 x 30.4 x 14.0 mm
