Artree021/OpenTendonHand/solidworks/腕部支撑架1.SLDPRT

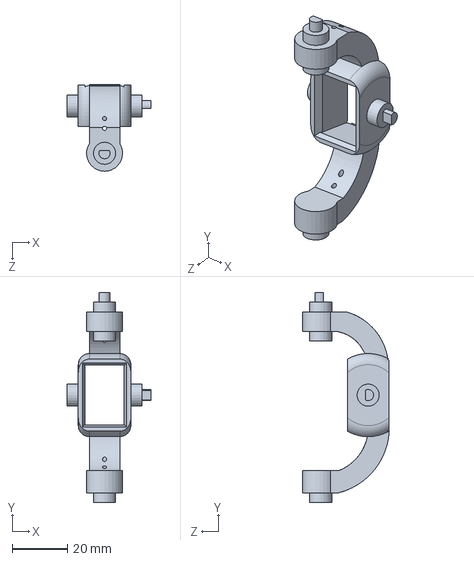
[picture p73: CAD file, 2026-11-03]
solidworks/腕部支撑架1.SLDPRT
30.2 x 75.7 x 31.2 mm
