Artree021/OpenTendonHand/solidworks/大拇指根部件2_all.SLDPRT

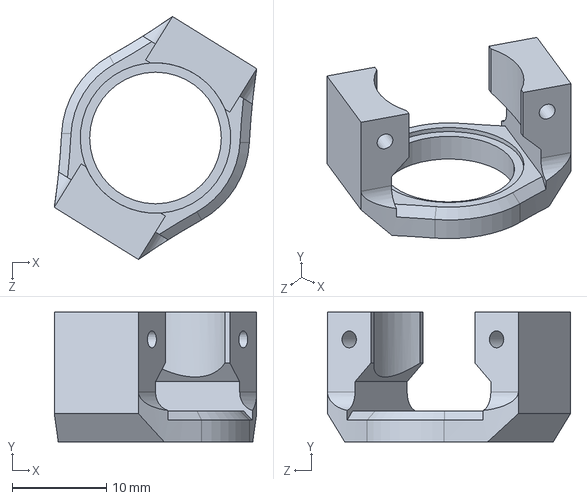
[picture p74: CAD file, 2026-11-03]
solidworks/大拇指根部件2_all.SLDPRT
21.5 x 13.8 x 25.8 mm
