Artree021/OpenTendonHand/solidworks/前指拇_圆盘型_all.SLDPRT

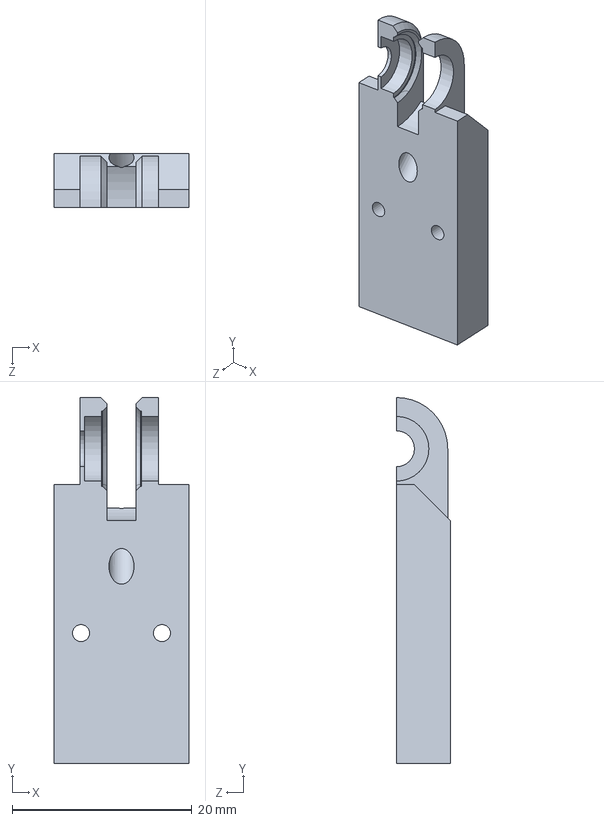
[picture p75: CAD file, 2026-11-03]
solidworks/前指拇_圆盘型_all.SLDPRT
15.0 x 40.7 x 6.00 mm
