Artree021/OpenTendonHand/solidworks/底座侧罩2.SLDPRT

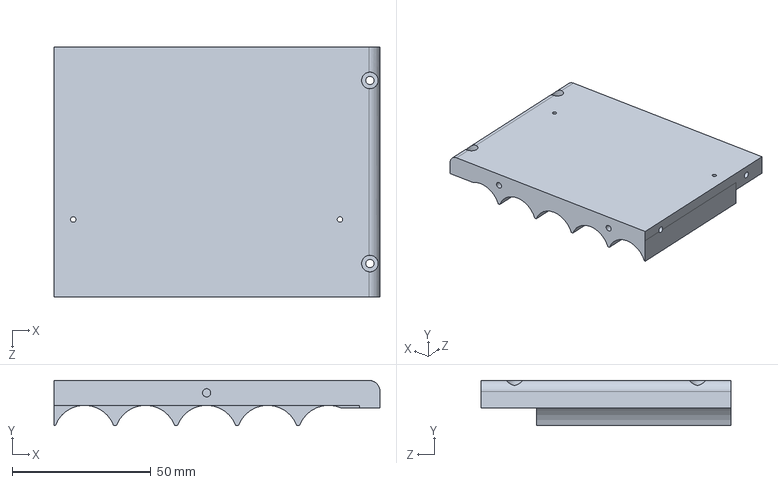
[picture p76: CAD file, 2026-11-03]
solidworks/底座侧罩2.SLDPRT
117.5 x 16.3 x 90.0 mm
