Artree021/OpenTendonHand/solidworks/后近指节_圆盘型_all.SLDPRT

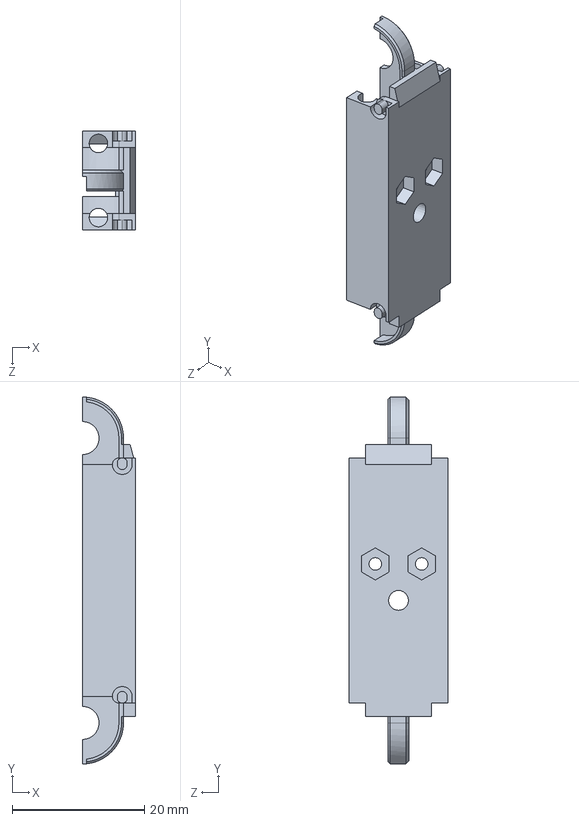
[picture p77: CAD file, 2026-11-03]
solidworks/后近指节_圆盘型_all.SLDPRT
8.00 x 55.4 x 15.0 mm
