Artree021/OpenTendonHand/solidworks/电机轴套_双通.SLDPRT

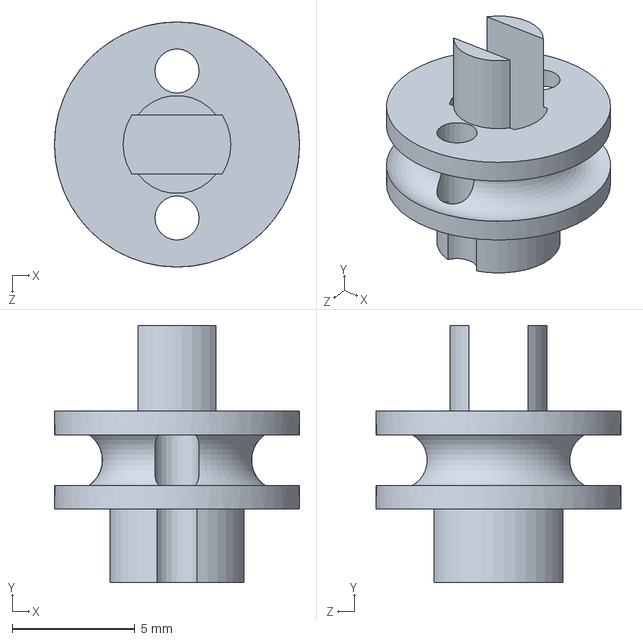
[picture p78: CAD file, 2026-11-03]
solidworks/电机轴套_双通.SLDPRT
10.0 x 10.5 x 10.0 mm
