Artree021/OpenTendonHand/solidworks/底座顶1.SLDPRT

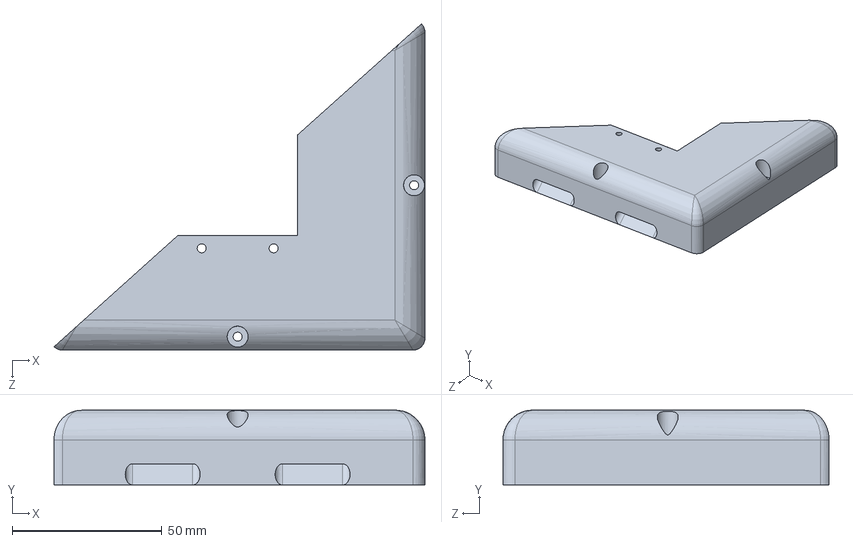
[picture p79: CAD file, 2026-11-03]
solidworks/底座顶1.SLDPRT
123.8 x 25.0 x 108.8 mm
