Artree021/OpenTendonHand/solidworks/底座侧罩4.SLDPRT

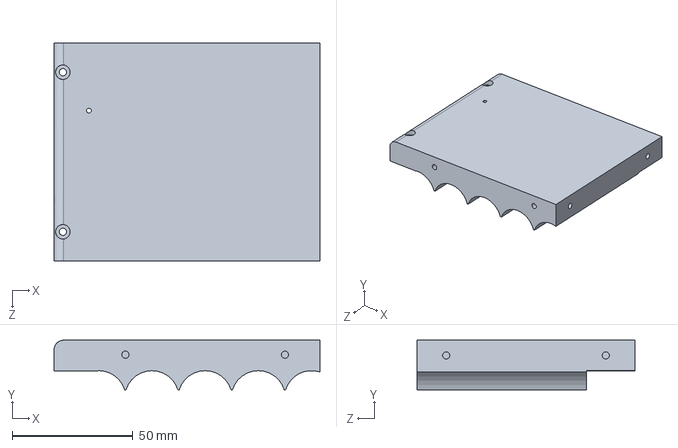
[picture p80: CAD file, 2026-11-03]
solidworks/底座侧罩4.SLDPRT
110.0 x 20.5 x 90.0 mm
