Artree021/OpenTendonHand/solidworks/电机底板.SLDASM

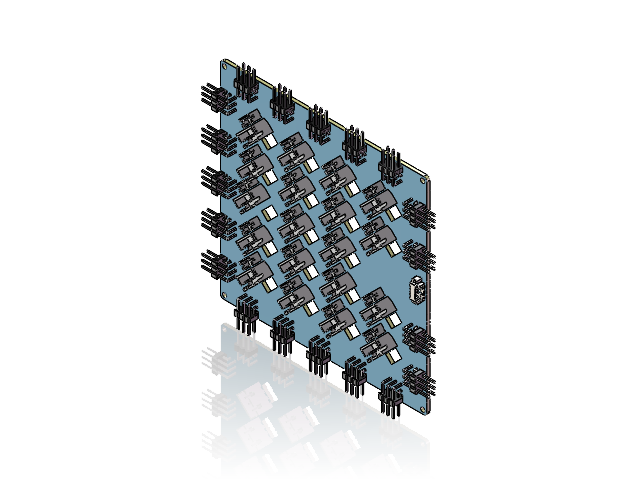
[picture p82: CAD file, 2026-11-03]
solidworks/电机底板.SLDASM
HDR-TH_6P-P2.54-H-M-R2-C3-S2.54~HDR-TH_6P-P2.54-M-WI-2X3P~Z7h2^复件 H1~HDR-TH_6P-P2.54-H-M-R2-C3-S2.54~HDR-TH_6P-P2.54-M-WI-2X3P~Z7h2_电机底板 x 19
CONN-TH_3P-P2.54_2501S-3P~CONN-TH_3P-P2.54_2501S-3P~Z7h2^复件 CN1~CONN-TH_3P-P2.54_2501S-3P~CONN-TH_3P-P2.54_2501S-3P~Z7h2_电机底板 x 19
CONN-TH_DF13-4P-1.25DSA~CONN-TH_DF13-4P-1.25DSA~Z7h2^复件 CN2~CONN-TH_DF13-4P-1.25DSA~CONN-TH_DF13-4P-1.25DSA~Z7h2_电机底板 x 19
CONN-SMD_4P-P1.25-HC-1.25-4PWT~CONN-SMD_4P-P1.25-HC-1.25-4PWT~Z7h2^复件 CN39~CONN-SMD_4P-P1.25-HC-1.25-4PWT~CONN-SMD_4P-P1.25-HC-1.25-4PWT~Z7h2_电机底板
复件 Board~Z7h2
