Artree021/OpenTendonHand/(list of files, cad)

Other CAD files:
solidworks/关节轴_圆盘型_all.SLDPRT
solidworks/关节轴_代2圆盘型_all.SLDPRT
solidworks/总电源板.SLDPRT
solidworks/8_14_4法兰轴承_代2圆盘型_all.SLDPRT
solidworks/P_关节电位器_圆盘型_all.SLDPRT
solidworks/复件 Board~Z7h2.SLDPRT
solidworks/P2_关节电位器_圆盘型_all.SLDPRT
solidworks/小法兰轴承_代2圆盘型_all.SLDPRT
solidworks/机械手整体.SLDASM
