Artree021/OpenTendonHand/(commit log)

2026-11-03 docs: bootstrap the OpenTendonHand repository
    Add the project scaffold for an open-source high-DOF tendon-driven
    dexterous hand: bilingual README, design and subsystem documentation
    placeholders, licensing split across CERN-OHL-S-2.0 (hardware), MIT
    (software) and CC BY 4.0 (docs), contribution guide, code of conduct,
    security policy, issue and pull-request templates, and Git LFS rules for
    CAD, mesh and PCB binaries.
    The mechanical and electronics sections are intentionally empty: the
    directory structure and parameter tables exist so that design files land
    in a predictable place instead of in a chat message.
2026-11-03 docs: simplify the repository to a design-file archive
    Keep only the four content directories -- SolidWorks 2025 models, STEP
    models, PCB files and the Word design document -- plus README, LICENSE
    and the Git LFS rules for model binaries. Drop the process documentation,
    templates and empty specification placeholders that this release does not
    need.
2026-11-03 docs: add an English README and a language switcher
2026-11-03 feat: publish the mechanical models, images and PCB reference
    - solidworks/: 60 parts + 8 assemblies (SolidWorks 2025)
    - step/: whole-hand STEP export
    - images/: hand photo, PCB renders and schematic
    - pcb/: link to the OSHWHub board project
    - README: add the hand photo and a PCB section
    [6s电池.SLDPRT, 8_12_3.5法兰轴承_all.SLDPRT, 8_14_4法兰轴承_all.SLDPRT, 8_14_4法兰轴承_代2圆盘型_all.SLDPRT, P2_关节电位器_代2圆盘型_all.SLDPRT, P2_关节电位器_圆盘型_all.SLDPRT, P_关节电位器_代2圆盘型_all.SLDPRT, P_关节电位器_圆盘型_all.SLDPRT]
2026-11-03 feat: add Gerber files and hand renders, scale the PCB figures
2026-11-03 docs: put the PCB figures on their own line
